loejuken/Keyboard/LayoutImage.png

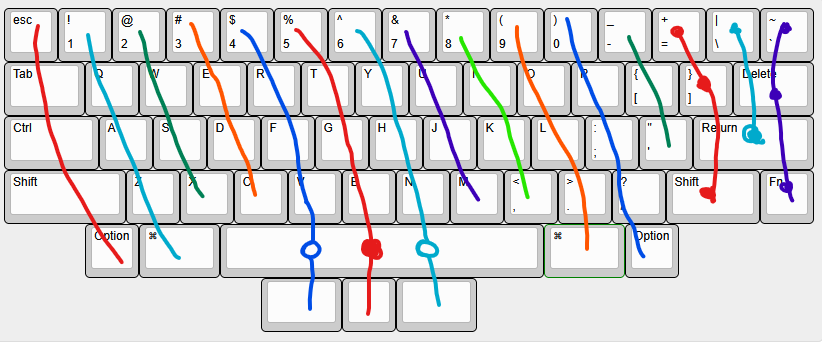
LayoutImage.png
