loejuken/Keyboard/usbschema.png

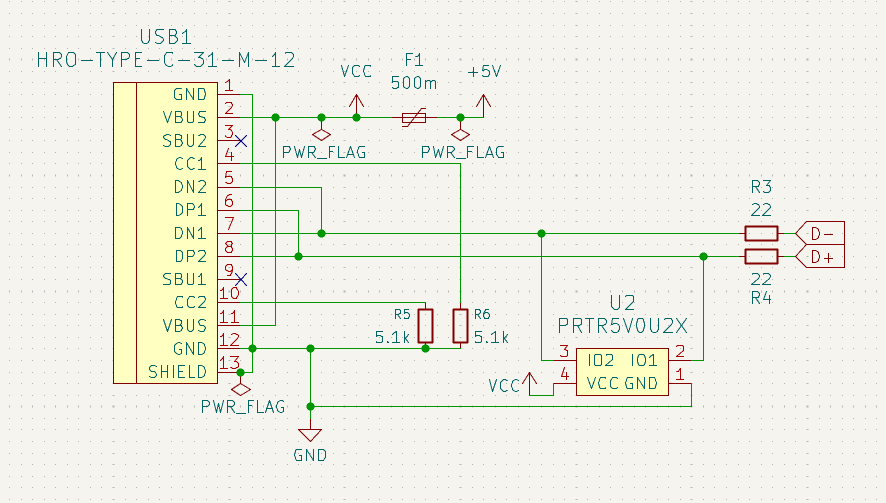
usbschema.png
