loejuken/Keyboard/ai03-pcb-guide.kicad_pcb

## KiCad design ai03-pcb-guide.kicad_pcb (2026-07-22)

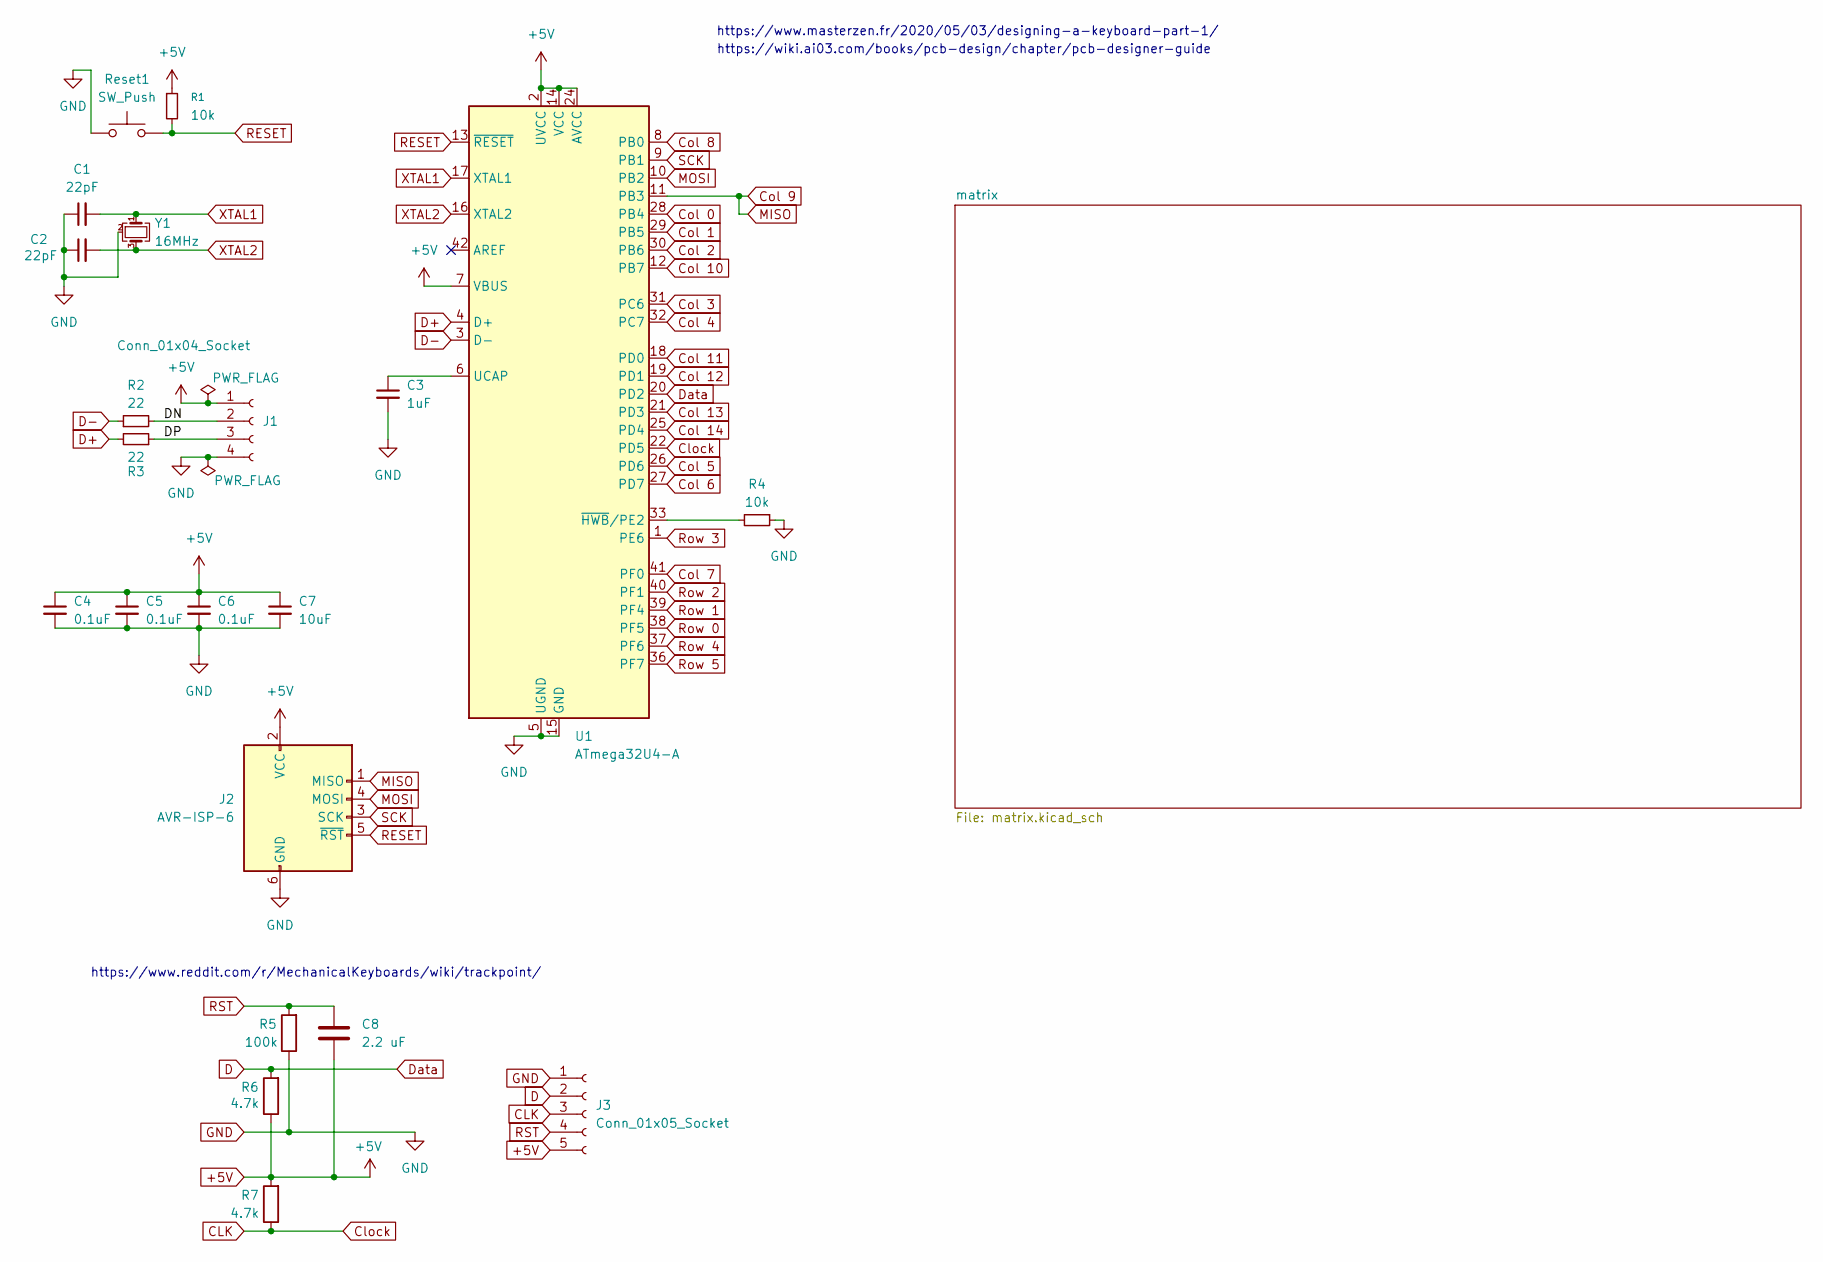
[picture p3: schematic ai03-pcb-guide.kicad_sch]

Parts:
C1, C2: 22pF; C_0603_1608Metric; LCSC Part # C1653
C3: 1uF; C_0603_1608Metric; LCSC Part # C15849
C4, C5, C6: 0.1uF; C_0603_1608Metric; LCSC Part # C14663
C7: 10uF; C_0603_1608Metric; LCSC Part # C19702
C8: 2.2 uF; C_0603_1608Metric; LCSC Part # C1607
J1: Conn_01x04_Socket; Molex_Pico-EZmate_78171-0004_1x04-1MP_P1.20mm_Vertical; LCSC Part # C588524
J2: AVR-ISP-6; Reset_Pretty-Mask
J3: Conn_01x05_Socket; Molex_Pico-EZmate_78171-0005_1x05-1MP_P1.20mm_Vertical; LCSC Part # C724177
R1, R4: 10k; R_0603_1608Metric; LCSC Part # C25804
R2, R3: 22; R_0603_1608Metric; LCSC Part # C23345
R5: 100k; R_0603_1608Metric; LCSC Part # C25803
R6, R7: 4.7k; R_0603_1608Metric; LCSC Part # C23162
Reset1: SW_Push; SW_SPST_SKQG_WithStem; LCSC Part # C115351
U1: ATmega32U4-A; TQFP-44_10x10mm_P0.8mm; LCSC Part # C44854
Y1: 16MHz; Crystal_SMD_3225-4Pin_3.2x2.5mm; LCSC Part # C12668

Connections:
+5V: C4.1, C5.1, C6.1, C7.1, C8.2, J1.1, J2.2 (VCC), J3.5, R1.1, R6.1, R7.2, U1.2 (UVCC), U1.7 (VBUS), U1.14 (VCC), U1.24 (AVCC), U1.34 (VCC), U1.44 (AVCC)
/DN: J1.2, R2.2
/DP: J1.3, R3.1
CLK: J3.3, R7.1, U1.22 (PD5)
Col 0: U1.28 (PB4); also elsewhere on the board
Col 1: U1.29 (PB5); also elsewhere on the board
Col 2: U1.30 (PB6); also elsewhere on the board
Col 3: U1.31 (PC6); also elsewhere on the board
Col 4: U1.32 (PC7); also elsewhere on the board
Col 5: U1.26 (PD6); also elsewhere on the board
Col 6: U1.27 (PD7); also elsewhere on the board
Col 7: U1.41 (PF0); also elsewhere on the board
Col 8: U1.8 (PB0); also elsewhere on the board
Col 9: J2.1 (MISO), U1.11 (PB3); also elsewhere on the board
Col 10: U1.12 (PB7); also elsewhere on the board
Col 11: U1.18 (PD0); also elsewhere on the board
Col 12: U1.19 (PD1); also elsewhere on the board
Col 13: U1.21 (PD3); also elsewhere on the board
Col 14: U1.25 (PD4); also elsewhere on the board
D: J3.2, R6.2, U1.20 (PD2)
D+: R3.2, U1.4 (D+)
D-: R2.1, U1.3 (D-)
GND: C1.1, C2.1, C3.2, C4.2, C5.2, C6.2, C7.2, J1.4, J2.6 (GND), J3.1, R4.1, R5.1, Reset1.1, U1.5 (UGND), U1.15 (GND), U1.23 (GND), U1.35 (GND), U1.43 (GND), Y1.2 (G), Y1.4 (G)
MOSI: J2.4 (MOSI), U1.10 (PB2)
unnamed: C3.1, U1.6 (UCAP)
unnamed: R4.2, U1.33 (~HWB/PE2)
RESET: J2.5 (~RST), R1.2, Reset1.2, U1.13 (~RESET)
RST: C8.1, J3.4, R5.2
Row 0: U1.38 (PF5); also elsewhere on the board
Row 1: U1.39 (PF4); also elsewhere on the board
Row 2: U1.40 (PF1); also elsewhere on the board
Row 3: U1.1 (PE6); also elsewhere on the board
Row 4: U1.37 (PF6); also elsewhere on the board
Row 5: U1.36 (PF7); also elsewhere on the board
SCK: J2.3 (SCK), U1.9 (PB1)
XTAL1: C1.2, U1.17 (XTAL1), Y1.1
XTAL2: C2.2, U1.16 (XTAL2), Y1.3

Notes on the sheet:
https://www.masterzen.fr/2020/05/03/designing-a-keyboard-part-1/
https://wiki.ai03.com/books/pcb-design/chapter/pcb-designer-guide
https://www.reddit.com/r/MechanicalKeyboards/wiki/trackpoint/

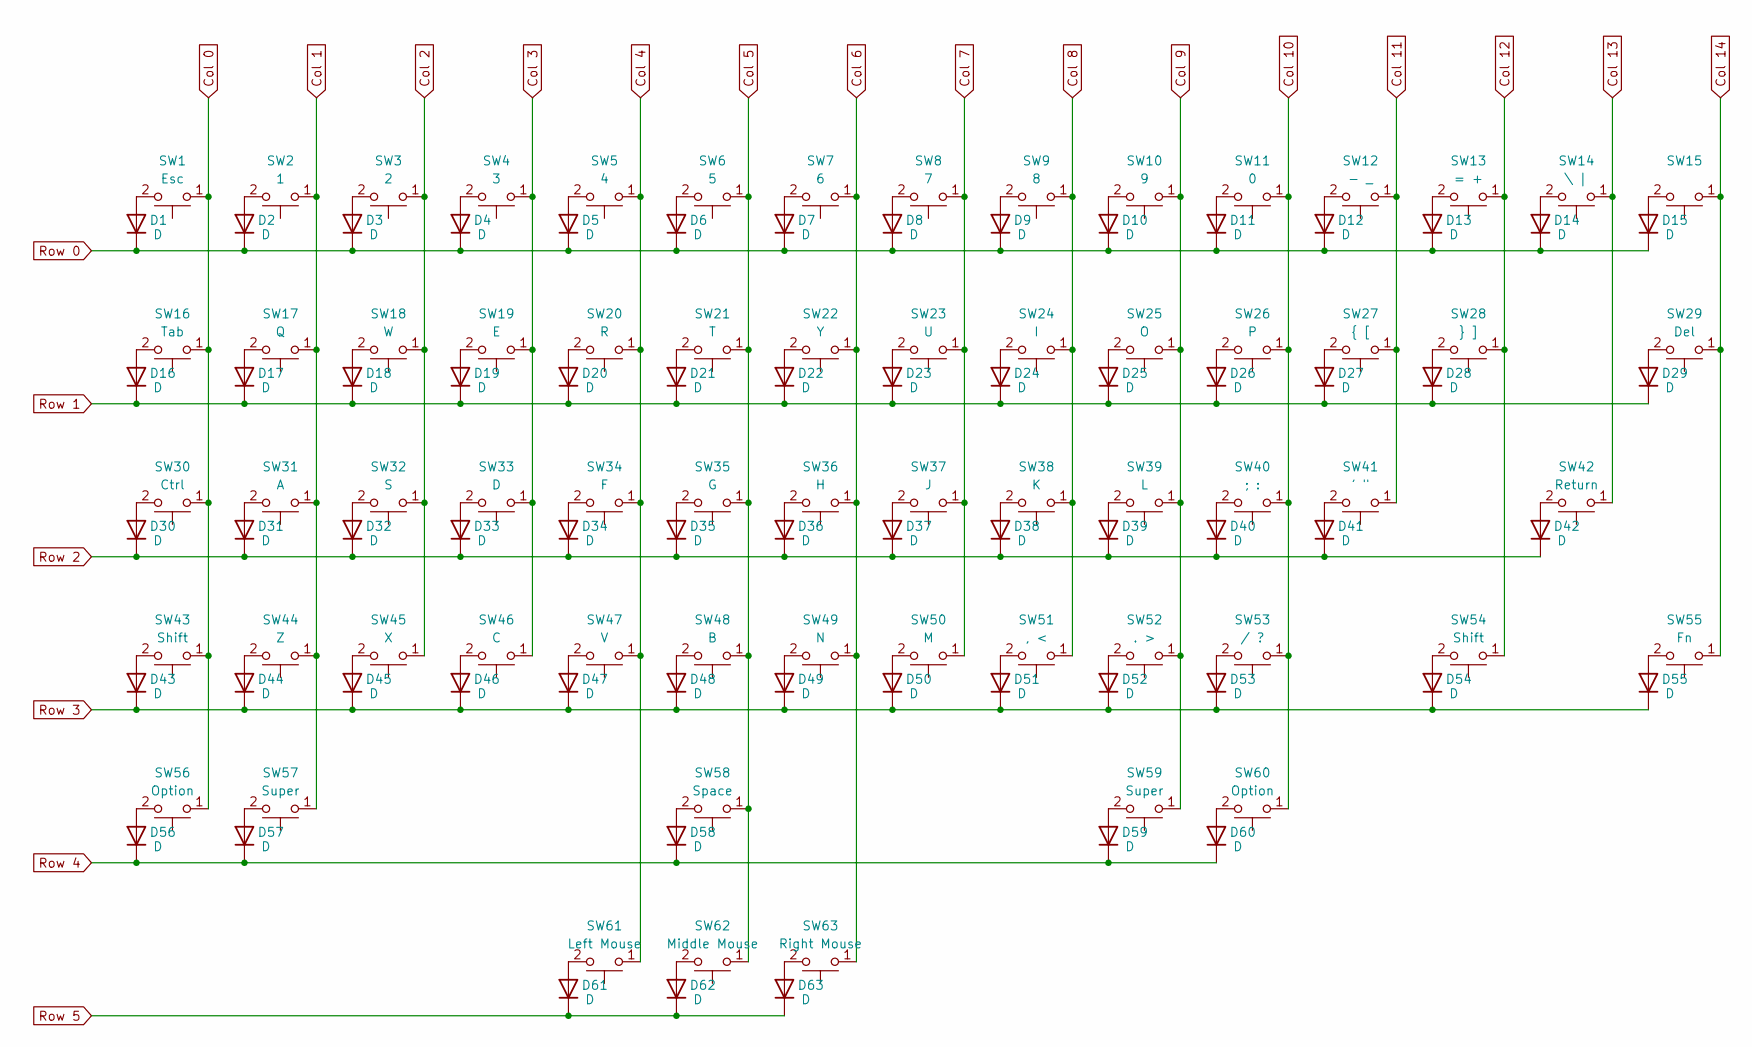
[picture p4: schematic matrix.kicad_sch]

Parts:
D1, D2, D3, D4, D5, D6, D7, D8, D9, D10, D11, D12, D13, D14, D15, D16, D17, D18, D19, D20, D21, D22, D23, D24, D25, D26, D27, D28, D29, D30, D31, D32, D33, D34, D35, D36, D37, D38, D39, D40, D41, D42, D43, D44, D45, D46, D47, D48, D49, D50, D51, D52, D53, D54, D55, D56, D57, D58, D59, D60, D61, D62, D63: D; D_SOD-123; LCSC Part # C83528
SW1: Esc; MXOnly-1U
SW2: 1; MXOnly-1U
SW3: 2; MXOnly-1U
SW4: 3; MXOnly-1U
SW5: 4; MXOnly-1U
SW6: 5; MXOnly-1U
SW7: 6; MXOnly-1U
SW8: 7; MXOnly-1U
SW9: 8; MXOnly-1U
SW10: 9; MXOnly-1U
SW11: 0; MXOnly-1U
SW12: - _; MXOnly-1U
SW13: = +; MXOnly-1U
SW14: \ |; MXOnly-1U
SW15: MXOnly-1U
SW16: Tab; MXOnly-1.5U
SW17: Q; MXOnly-1U
SW18: W; MXOnly-1U
SW19: E; MXOnly-1U
SW20: R; MXOnly-1U
SW21: T; MXOnly-1U
SW22: Y; MXOnly-1U
SW23: U; MXOnly-1U
SW24: I; MXOnly-1U
SW25: O; MXOnly-1U
SW26: P; MXOnly-1U
SW27: { [; MXOnly-1U
SW28: } ]; MXOnly-1U
SW29: Del; MXOnly-1.5U
SW30: Ctrl; MXOnly-1.75U
SW31: A; MXOnly-1U
SW32: S; MXOnly-1U
SW33: D; MXOnly-1U
SW34: F; MXOnly-1U
SW35: G; MXOnly-1U
SW36: H; MXOnly-1U
SW37: J; MXOnly-1U
SW38: K; MXOnly-1U
SW39: L; MXOnly-1U
SW40: ; :; MXOnly-1U
SW41: ' "; MXOnly-1U
SW42: Return; MXOnly-2.25U
SW43: Shift; MXOnly-2.25U-ReversedStabilizers-NoLED
SW44: Z; MXOnly-1U
SW45: X; MXOnly-1U
SW46: C; MXOnly-1U
SW47: V; MXOnly-1U
SW48: B; MXOnly-1U
SW49: N; MXOnly-1U
SW50: M; MXOnly-1U
SW51: , <; MXOnly-1U
SW52: . >; MXOnly-1U
SW53: / ?; MXOnly-1U
SW54: Shift; MXOnly-1.75U
SW55: Fn; MXOnly-1U
SW56, SW60: Option; MXOnly-1U
SW57, SW59: Super; MXOnly-1.5U
SW58: Space; MXOnly-6U-ReversedStabilizers-NoLED
SW61: Left Mouse; KailhChoc-1.5U
SW62: Middle Mouse; KailhChoc-1U
SW63: Right Mouse; KailhChoc-1.5U

Connections:
Col 0: SW1.1, SW16.1, SW30.1, SW43.1, SW56.1; also elsewhere on the board
Col 1: SW2.1, SW17.1, SW31.1, SW44.1, SW57.1; also elsewhere on the board
Col 2: SW3.1, SW18.1, SW32.1, SW45.1; also elsewhere on the board
Col 3: SW4.1, SW19.1, SW33.1, SW46.1; also elsewhere on the board
Col 4: SW5.1, SW20.1, SW34.1, SW47.1, SW61.1; also elsewhere on the board
Col 5: SW6.1, SW21.1, SW35.1, SW48.1, SW58.1, SW62.1; also elsewhere on the board
Col 6: SW7.1, SW22.1, SW36.1, SW49.1, SW63.1; also elsewhere on the board
Col 7: SW8.1, SW23.1, SW37.1, SW50.1; also elsewhere on the board
Col 8: SW9.1, SW24.1, SW38.1, SW51.1; also elsewhere on the board
Col 9: SW10.1, SW25.1, SW39.1, SW52.1, SW59.1; also elsewhere on the board
Col 10: SW11.1, SW26.1, SW40.1, SW53.1, SW60.1; also elsewhere on the board
Col 11: SW12.1, SW27.1, SW41.1; also elsewhere on the board
Col 12: SW13.1, SW28.1, SW54.1; also elsewhere on the board
Col 13: SW14.1, SW42.1; also elsewhere on the board
Col 14: SW15.1, SW29.1, SW55.1; also elsewhere on the board
unnamed: D1.2 (A), SW1.2
unnamed: D2.2 (A), SW2.2
unnamed: D3.2 (A), SW3.2
unnamed: D4.2 (A), SW4.2
unnamed: D5.2 (A), SW5.2
unnamed: D6.2 (A), SW6.2
unnamed: D7.2 (A), SW7.2
unnamed: D8.2 (A), SW8.2
unnamed: D9.2 (A), SW9.2
unnamed: D10.2 (A), SW10.2
unnamed: D11.2 (A), SW11.2
unnamed: D12.2 (A), SW12.2
unnamed: D13.2 (A), SW13.2
unnamed: D14.2 (A), SW14.2
unnamed: D15.2 (A), SW15.2
unnamed: D16.2 (A), SW16.2
unnamed: D17.2 (A), SW17.2
unnamed: D18.2 (A), SW18.2
unnamed: D19.2 (A), SW19.2
unnamed: D20.2 (A), SW20.2
unnamed: D21.2 (A), SW21.2
unnamed: D22.2 (A), SW22.2
unnamed: D23.2 (A), SW23.2
unnamed: D24.2 (A), SW24.2
unnamed: D25.2 (A), SW25.2
unnamed: D26.2 (A), SW26.2
unnamed: D27.2 (A), SW27.2
unnamed: D28.2 (A), SW28.2
unnamed: D29.2 (A), SW29.2
unnamed: D30.2 (A), SW30.2
unnamed: D31.2 (A), SW31.2
unnamed: D32.2 (A), SW32.2
unnamed: D33.2 (A), SW33.2
unnamed: D34.2 (A), SW34.2
unnamed: D35.2 (A), SW35.2
unnamed: D36.2 (A), SW36.2
unnamed: D37.2 (A), SW37.2
unnamed: D38.2 (A), SW38.2
unnamed: D39.2 (A), SW39.2
unnamed: D40.2 (A), SW40.2
unnamed: D41.2 (A), SW41.2
unnamed: D42.2 (A), SW42.2
unnamed: D43.2 (A), SW43.2
unnamed: D44.2 (A), SW44.2
unnamed: D45.2 (A), SW45.2
unnamed: D46.2 (A), SW46.2
unnamed: D47.2 (A), SW47.2
unnamed: D48.2 (A), SW48.2
unnamed: D49.2 (A), SW49.2
unnamed: D50.2 (A), SW50.2
unnamed: D51.2 (A), SW51.2
unnamed: D52.2 (A), SW52.2
unnamed: D53.2 (A), SW53.2
unnamed: D54.2 (A), SW54.2
unnamed: D55.2 (A), SW55.2
unnamed: D56.2 (A), SW56.2
unnamed: D57.2 (A), SW57.2
unnamed: D58.2 (A), SW58.2
unnamed: D59.2 (A), SW59.2
unnamed: D60.2 (A), SW60.2
unnamed: D61.2 (A), SW61.2
unnamed: D62.2 (A), SW62.2
unnamed: D63.2 (A), SW63.2
Row 0: D1.1 (K), D2.1 (K), D3.1 (K), D4.1 (K), D5.1 (K), D6.1 (K), D7.1 (K), D8.1 (K), D9.1 (K), D10.1 (K), D11.1 (K), D12.1 (K), D13.1 (K), D14.1 (K), D15.1 (K); also elsewhere on the board
Row 1: D16.1 (K), D17.1 (K), D18.1 (K), D19.1 (K), D20.1 (K), D21.1 (K), D22.1 (K), D23.1 (K), D24.1 (K), D25.1 (K), D26.1 (K), D27.1 (K), D28.1 (K), D29.1 (K); also elsewhere on the board
Row 2: D30.1 (K), D31.1 (K), D32.1 (K), D33.1 (K), D34.1 (K), D35.1 (K), D36.1 (K), D37.1 (K), D38.1 (K), D39.1 (K), D40.1 (K), D41.1 (K), D42.1 (K); also elsewhere on the board
Row 3: D43.1 (K), D44.1 (K), D45.1 (K), D46.1 (K), D47.1 (K), D48.1 (K), D49.1 (K), D50.1 (K), D51.1 (K), D52.1 (K), D53.1 (K), D54.1 (K), D55.1 (K); also elsewhere on the board
Row 4: D56.1 (K), D57.1 (K), D58.1 (K), D59.1 (K), D60.1 (K); also elsewhere on the board
Row 5: D61.1 (K), D62.1 (K), D63.1 (K); also elsewhere on the board

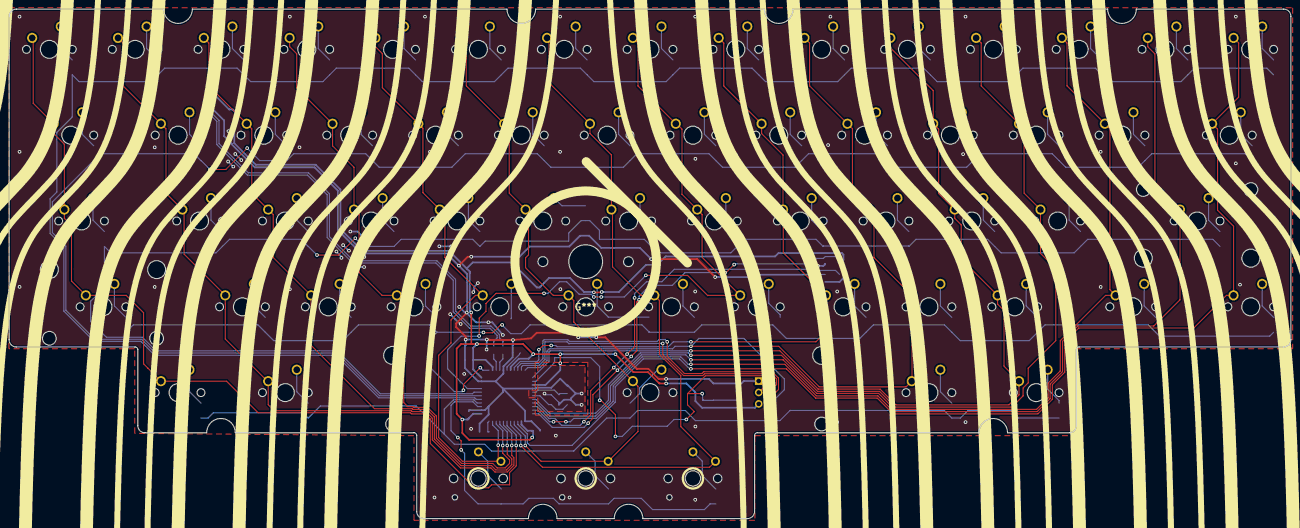
[picture p5: board ai03-pcb-guide.kicad_pcb from above]

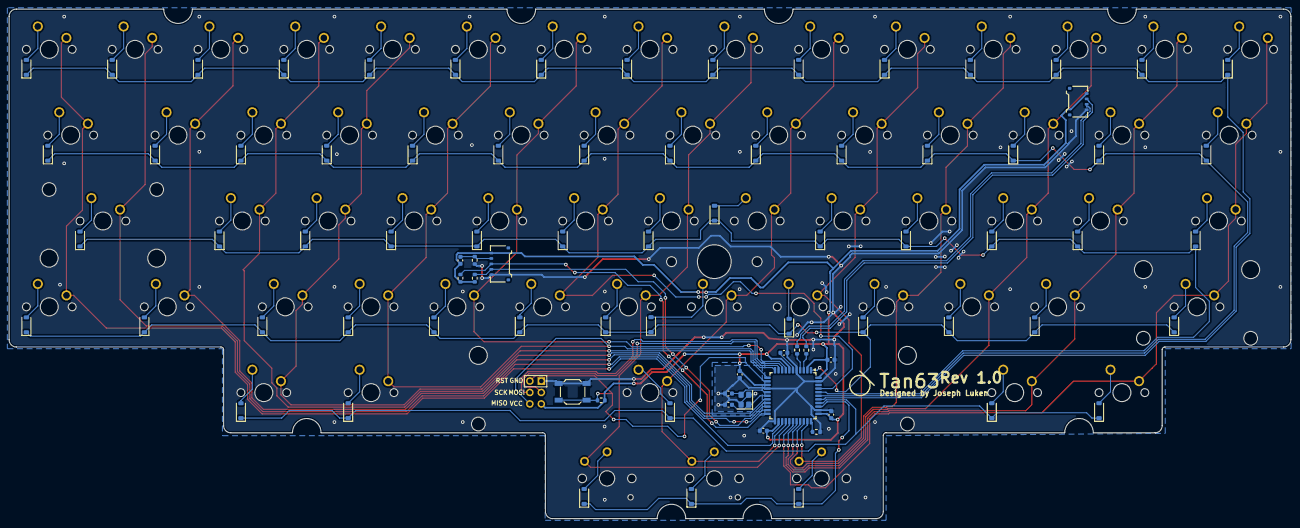
[picture p6: board ai03-pcb-guide.kicad_pcb from below]

Board: 2 copper layers, 284.5 x 113.1 mm, 147 parts (84 on the bottom side), 100 nets.
