loejuken/Keyboard/(commit log)

2026-06-08 Project file setup
    [ai03-pcb-guide.kicad_pcb, ai03-pcb-guide.kicad_sch]
2026-06-08 New Type C Lib and early MCU Schema
    [ai03-pcb-guide.kicad_sch]
2026-06-09 more MCU schema
    [ai03-pcb-guide.kicad_sch]
2026-06-10 MCU schema and matrix schema
    [ai03-pcb-guide.kicad_sch, matrix.kicad_sch]
2026-06-12 schema mostly done with footprints added
    [ai03-pcb-guide.kicad_pcb, ai03-pcb-guide.kicad_sch, matrix.kicad_sch]
2026-06-12 schema and pcb changes
    [ai03-pcb-guide.kicad_pcb, ai03-pcb-guide.kicad_sch]
2026-06-14 pcb finished except for routing
    [ai03-pcb-guide.kicad_pcb, ai03-pcb-guide.kicad_sch, matrix.kicad_sch]
2026-06-14 more revisions
    [ai03-pcb-guide.kicad_pcb, ai03-pcb-guide.kicad_sch, matrix.kicad_sch]
2026-06-15 fixing issues
    [ai03-pcb-guide.kicad_pcb]
2026-06-21 changed footprints because I did them wrong
2026-07-05 starting wiring tracks
    [ai03-pcb-guide.kicad_pcb, ai03-pcb-guide.kicad_sch]
2026-07-05 more tracing work
    [ai03-pcb-guide.kicad_pcb, ai03-pcb-guide.kicad_sch]
2026-07-12 most wiring complete
    [ai03-pcb-guide.kicad_pcb, ai03-pcb-guide.kicad_sch]
2026-07-13 added trackpoint wiring
    [ai03-pcb-guide.kicad_pcb, ai03-pcb-guide.kicad_sch]
2026-07-13 fill under mcu
    [ai03-pcb-guide.kicad_pcb]
2026-07-21 Almost finished
    [ai03-pcb-guide.kicad_pcb, ai03-pcb-guide.kicad_sch]
2026-07-21 Rev 1.0
    [ai03-pcb-guide.kicad_pcb, ai03-pcb-guide.kicad_sch]
2026-07-21 routing tweaks
    [ai03-pcb-guide.kicad_pcb]
2026-07-22 Added LCSC Part # Field
    [ai03-pcb-guide.kicad_pcb, ai03-pcb-guide.kicad_sch, matrix.kicad_sch]
2026-07-22 Tweaks and prod files
    [ai03-pcb-guide.kicad_pcb]
